mlesniew/rolek/(commit log)

2019-02-06 Pin number update
2019-02-06 Blink the builtin diode to indicate that the loop is running
2019-02-11 Add remote reset button on index.html
2019-02-15 During reset wait 5 seconds before powering remote back on
    If the time between power down and power up is too short, the remote
    does not fully reset.
    [rolek.ino]
2020-03-26 Use printf instead of Serial.println
2020-03-27 Fix bug in button to pin mapping
    [rolek.cpp]
2020-03-29 Disable buttons on Web UI while an operation is in progress
2020-04-09 Fix serving index.html by default
    [rolek.cpp]
2021-03-10 Use arduino_utils library for WiFi handling
2021-03-10 Switch to LittleFS
2021-05-31 Bump arduino_utils, use mDNS
2021-08-07 Add support for stop button
2022-04-13 Make reset button disable other buttons too for the time of the request
2023-01-15 Bump arduino_utils
2023-02-17 Use RestfulWebServer from Arduino Utils
2023-02-17 Switch to composition API
2023-08-09 Allow resetting the remote over MQTT and via Home Assistant
    [rolek.cpp]
2023-08-09 Construct Home Assistant device ids based on board ID
2023-08-10 Track shutter position
2023-08-11 Fix position update bug
    [shutter.cpp]
2023-08-15 Add ArduinoOTA
2023-10-30 Unify code to use Arduino strings only
2023-10-30 Skip MDNS updates as they are done by ArduinoOTA
    [rolek.cpp]
2024-03-10 Update to ArduinoJson 7
2024-12-21 Automatically reset if WiFi can't be connected for too long
    [rolek.cpp]
2025-03-23 Add shutter activity LED
